roymilsh/VLSI_4bit_ALU/ALU Simulations/ADD-SUB.PNG

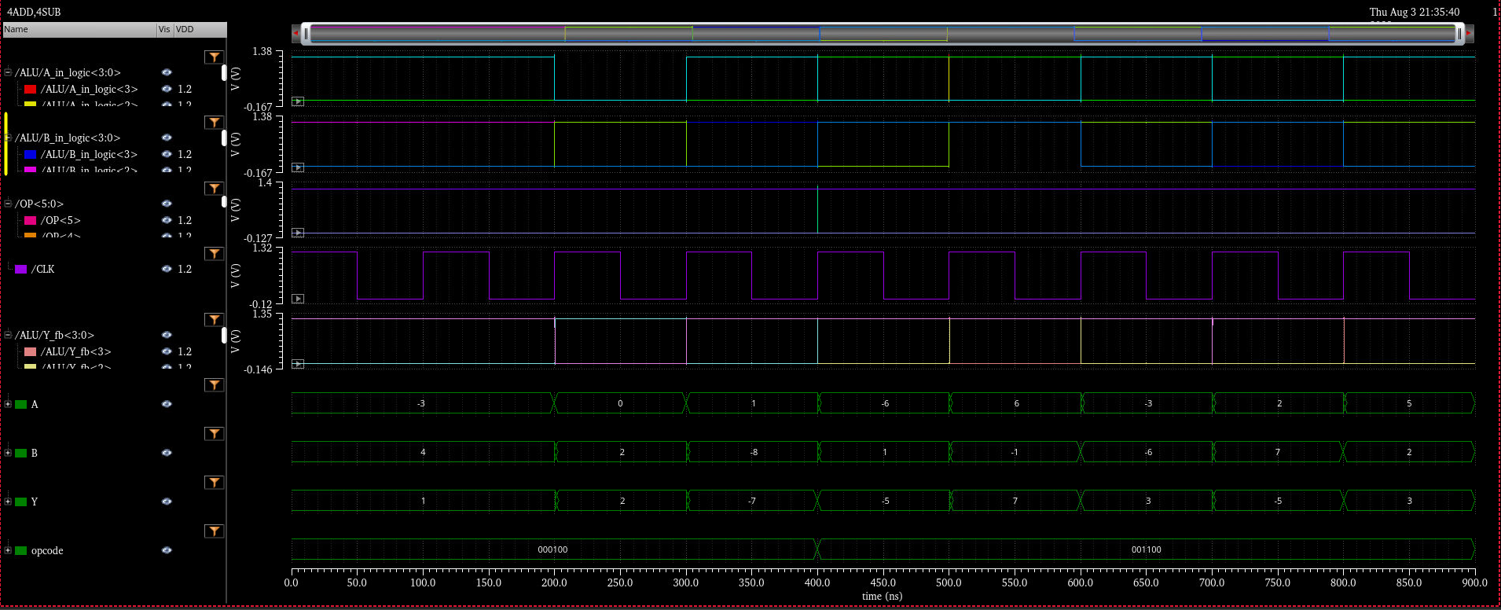
ALU Simulations/ADD-SUB.PNG
