roymilsh/VLSI_4bit_ALU/ALU Simulations/BSR.PNG

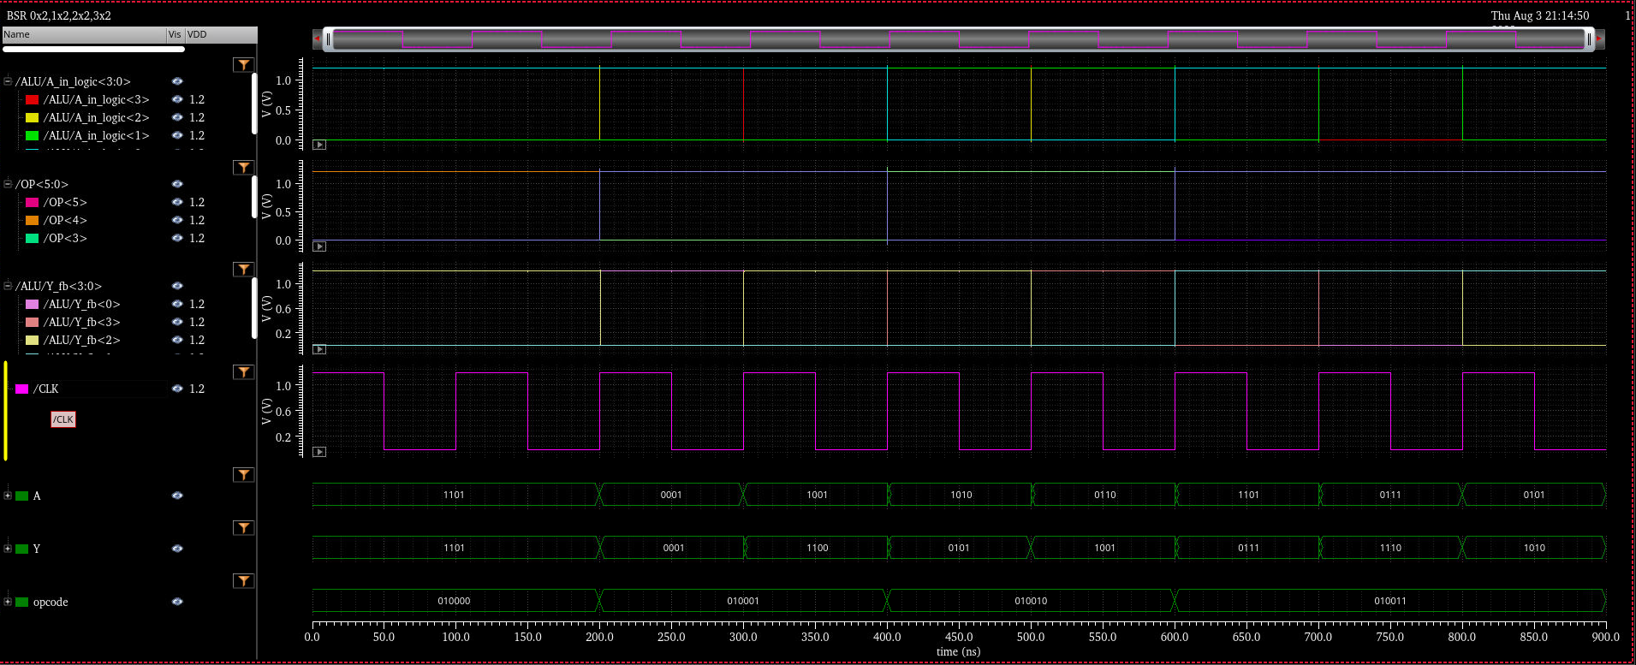
ALU Simulations/BSR.PNG
