roymilsh/VLSI_4bit_ALU/ALU Simulations/Feedback(add).PNG

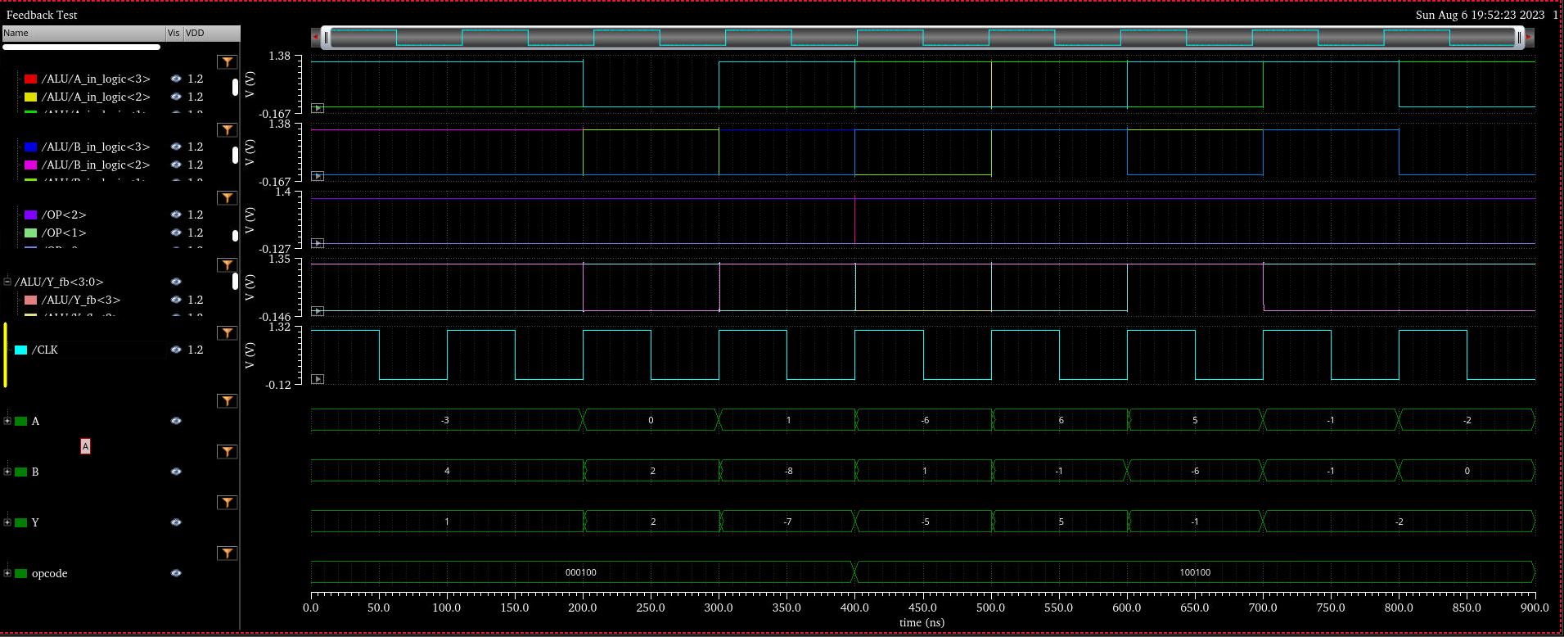
ALU Simulations/Feedback(add).PNG
