roymilsh/VLSI_4bit_ALU/ALU Simulations/NEG.PNG

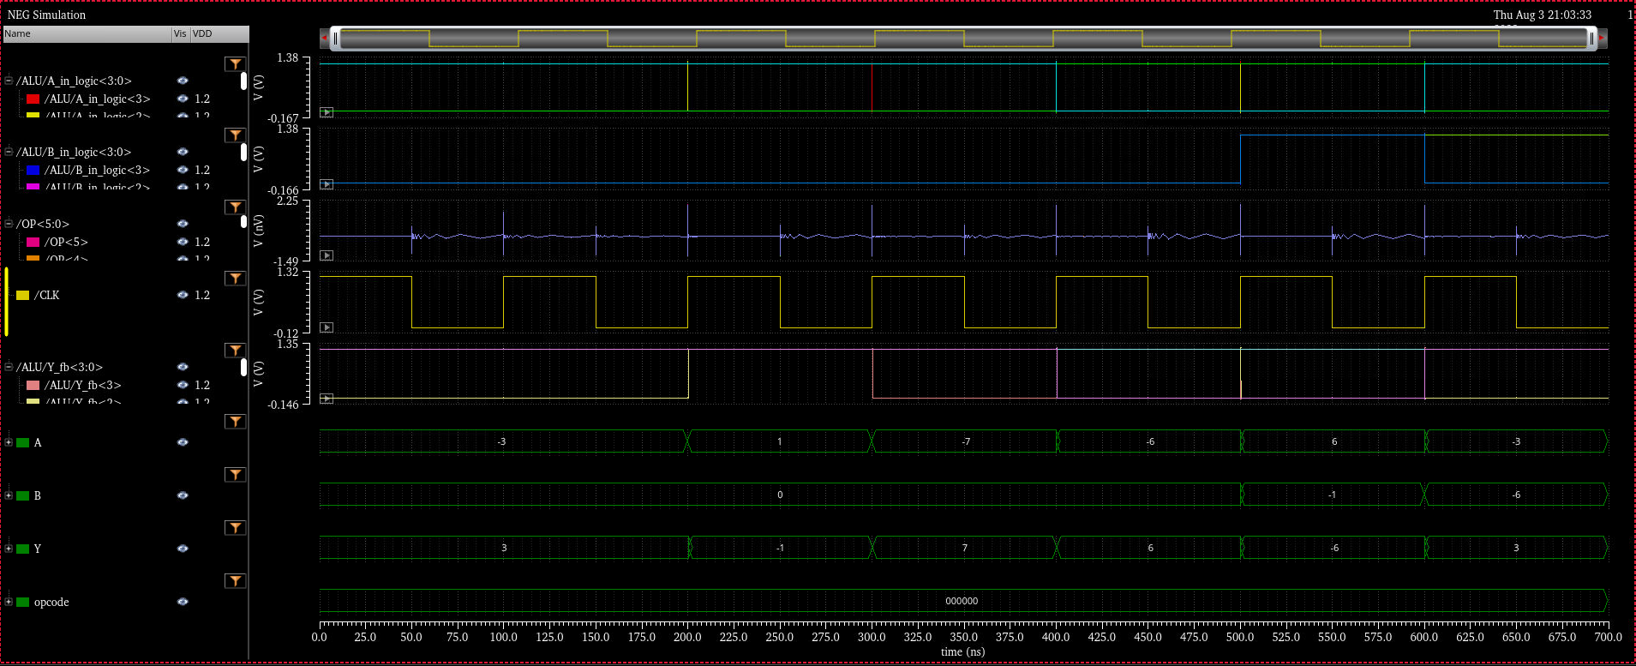
ALU Simulations/NEG.PNG
