roymilsh/VLSI_4bit_ALU/ALU Simulations/XOR-AND-OR.PNG

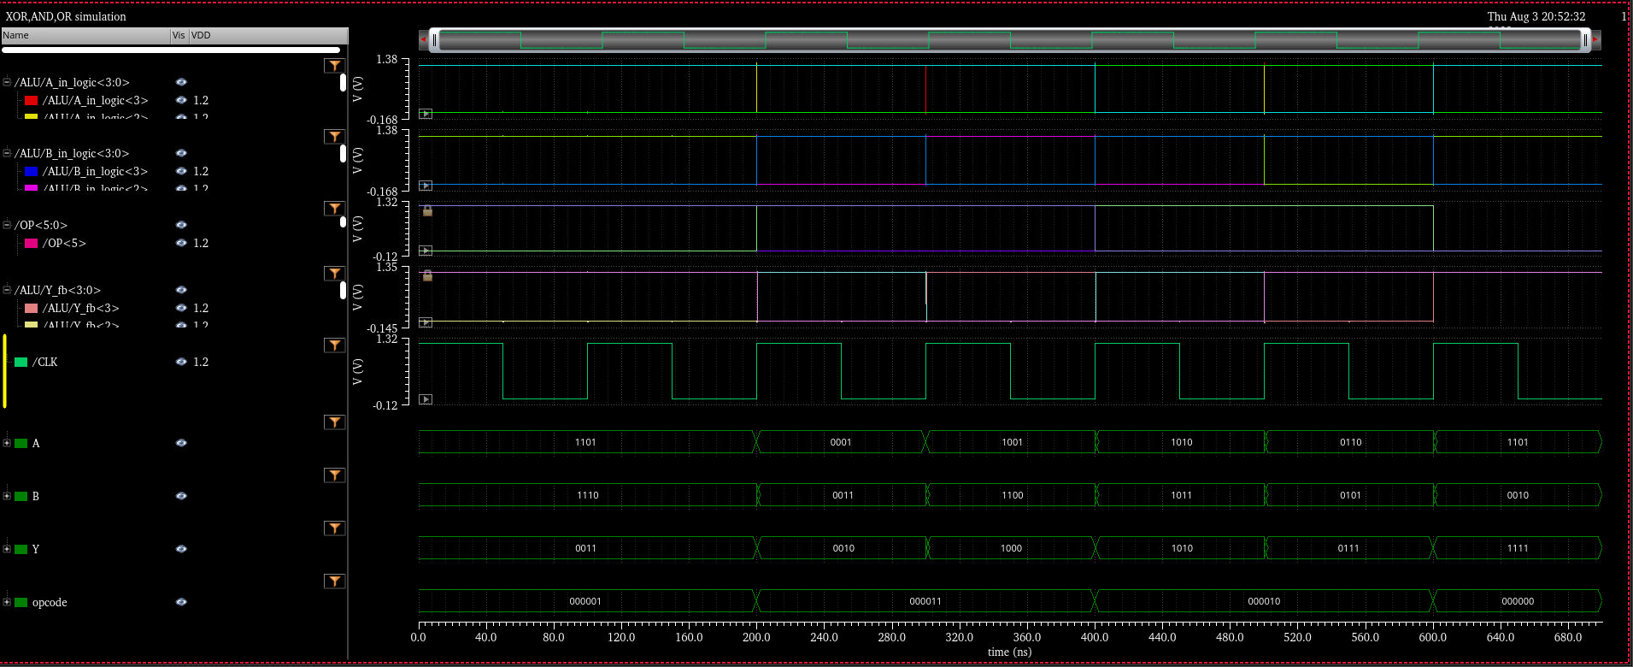
ALU Simulations/XOR-AND-OR.PNG
