roymilsh/VLSI_4bit_ALU/ALU_block_layout_virtuoso.PNG

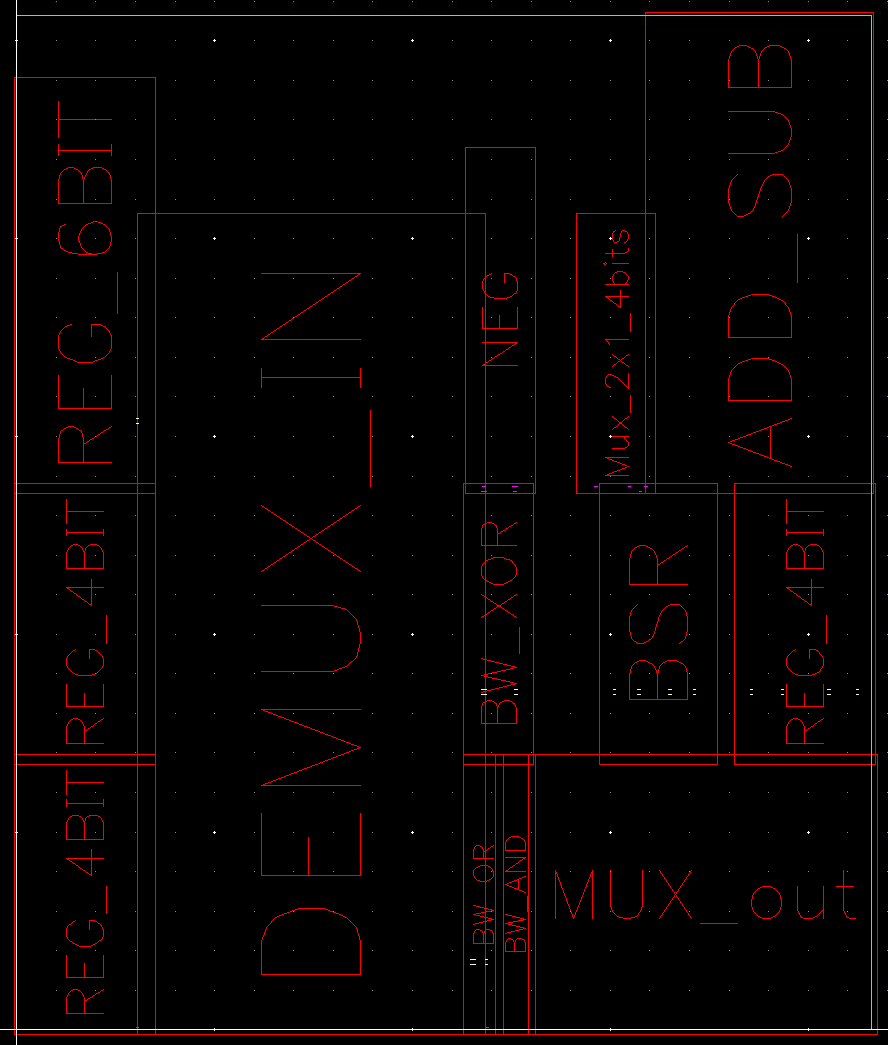
ALU_block_layout_virtuoso.PNG
