roymilsh/VLSI_4bit_ALU/ALU_full_layout_virtuoso.PNG

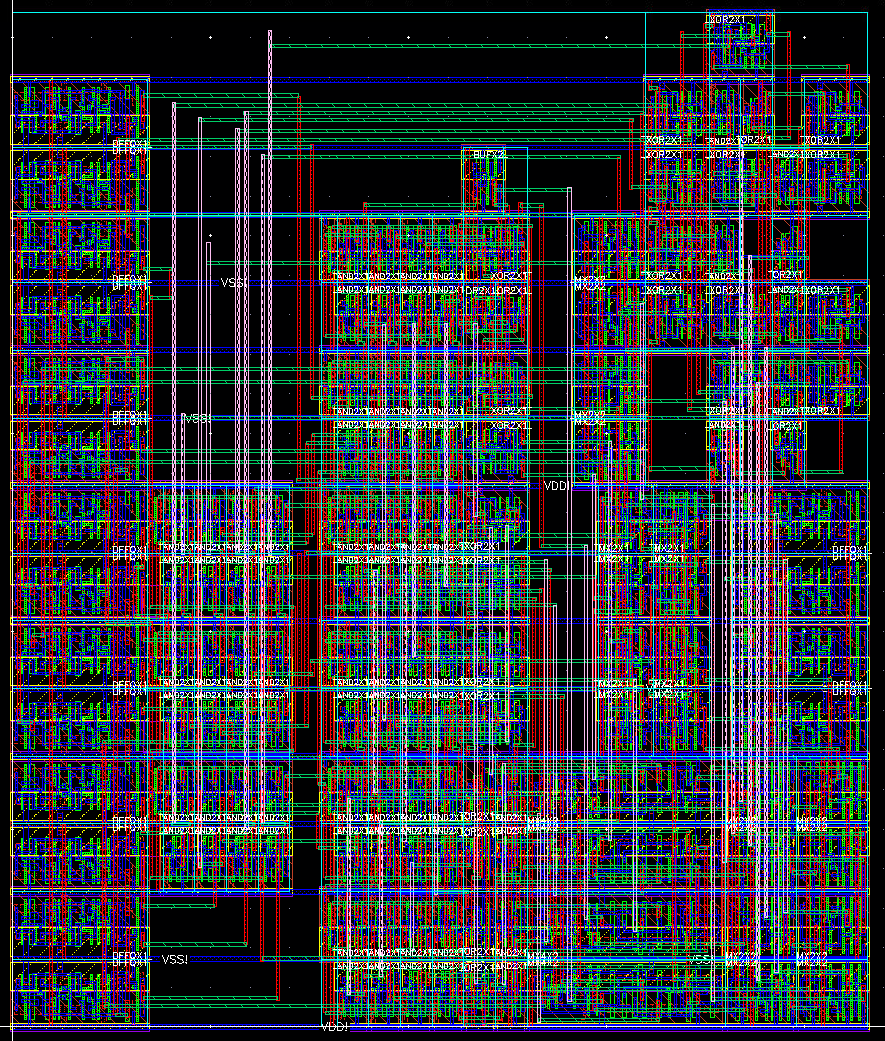
ALU_full_layout_virtuoso.PNG
