roymilsh/VLSI_4bit_ALU/layout sketch.PNG

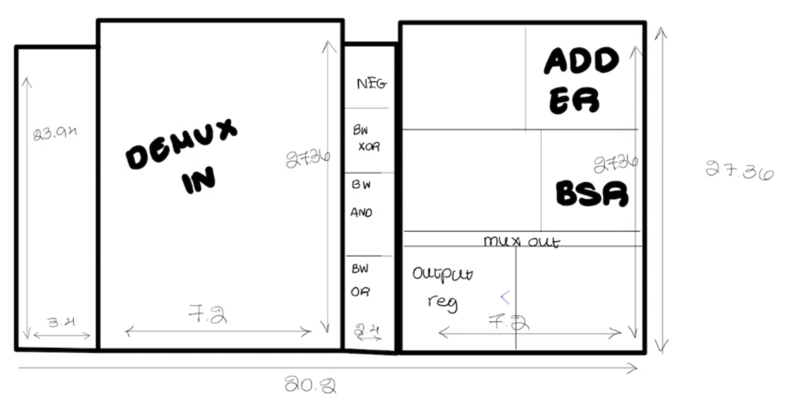
layout sketch.PNG
