roymilsh/VLSI_4bit_ALU/Logisim Implementation/BW_AND.PNG

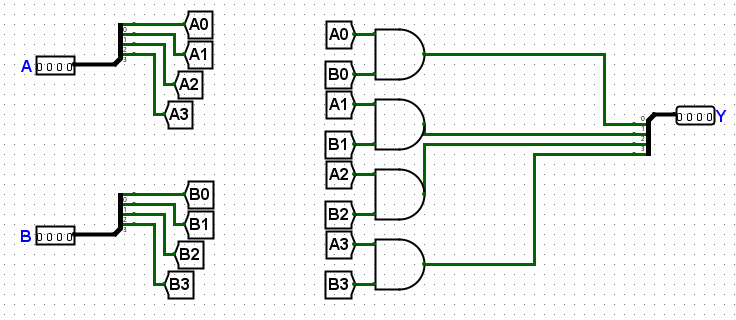
Logisim Implementation/BW_AND.PNG
