roymilsh/VLSI_4bit_ALU/Logisim Implementation/BW_NOT.PNG

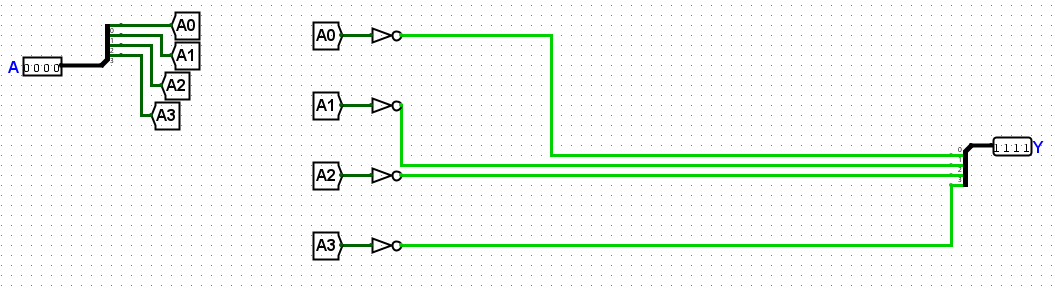
Logisim Implementation/BW_NOT.PNG
