roymilsh/VLSI_4bit_ALU/Logisim Implementation/BW_OR.PNG

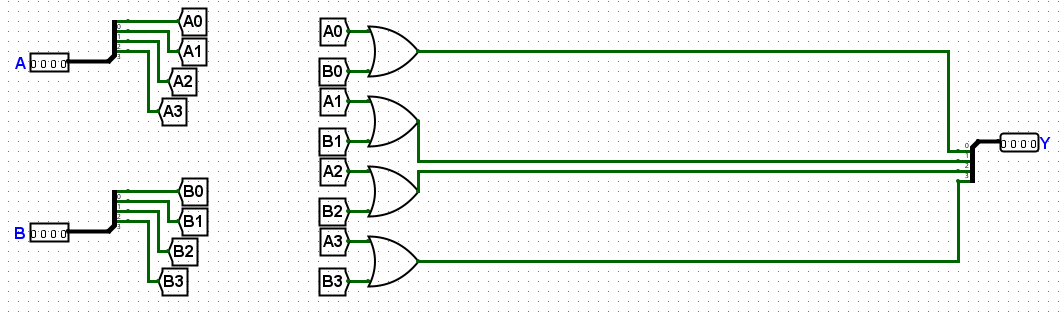
Logisim Implementation/BW_OR.PNG
