roymilsh/VLSI_4bit_ALU/Logisim Implementation/BW_XOR.PNG

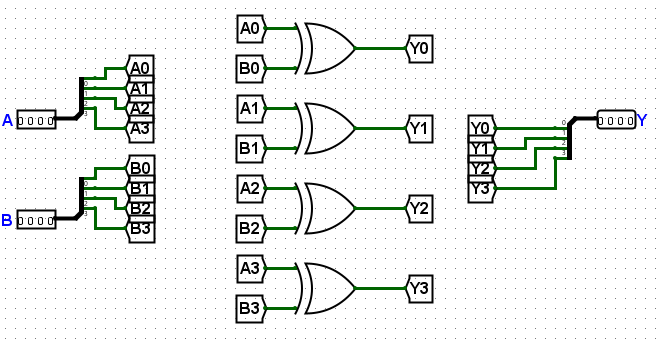
Logisim Implementation/BW_XOR.PNG
