roymilsh/VLSI_4bit_ALU/Logisim Implementation/DEMUX2.PNG

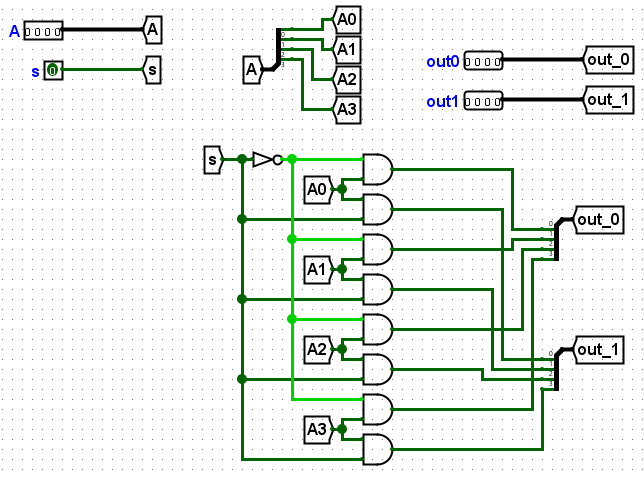
Logisim Implementation/DEMUX2.PNG
