roymilsh/VLSI_4bit_ALU/Logisim Implementation/DEMUX4.PNG

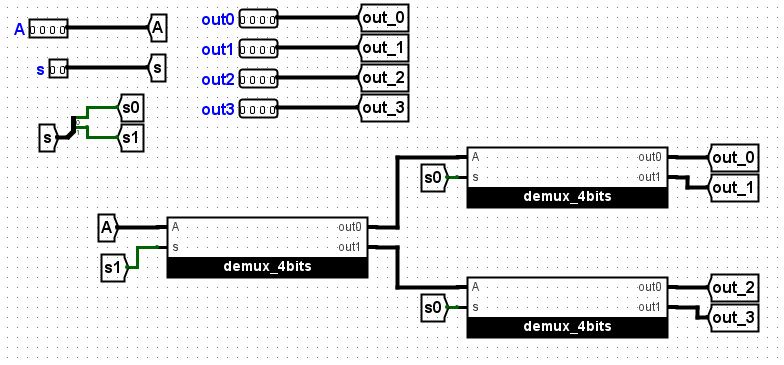
Logisim Implementation/DEMUX4.PNG
