roymilsh/VLSI_4bit_ALU/Logisim Implementation/DEMUX_IN.PNG

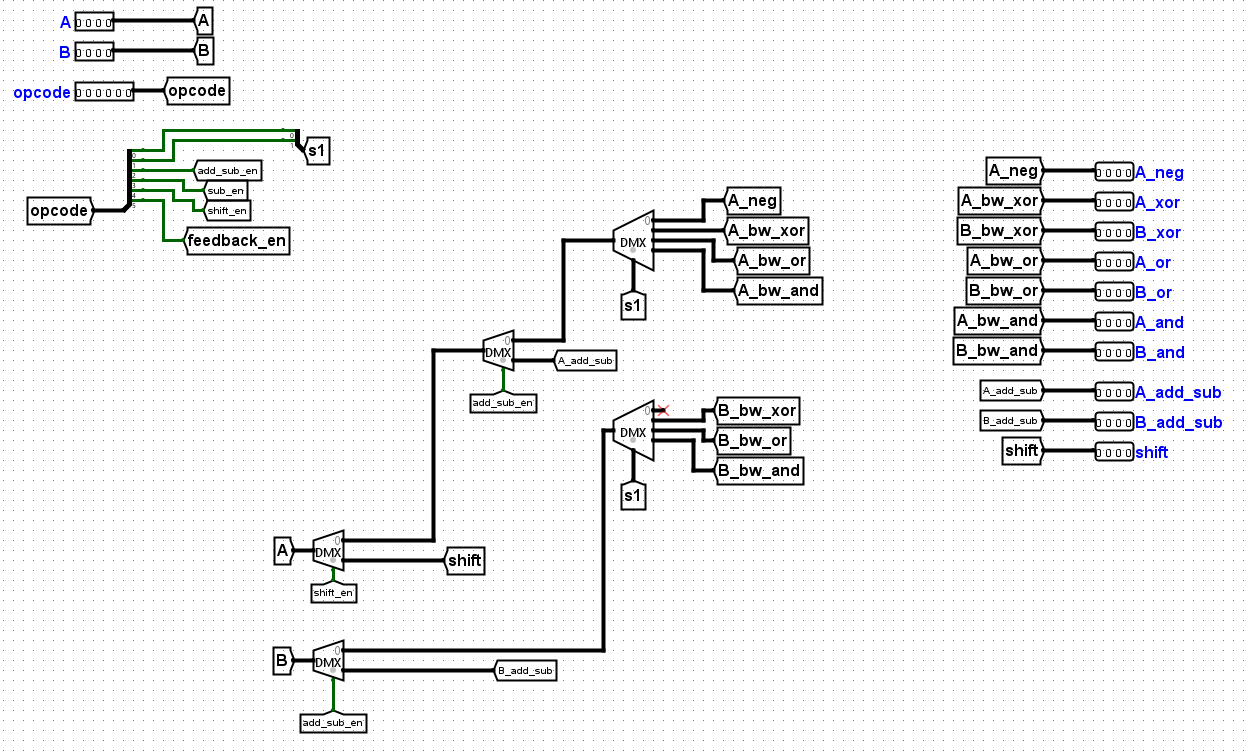
Logisim Implementation/DEMUX_IN.PNG
