roymilsh/VLSI_4bit_ALU/ALU Simulations/ADD-SUB.pdf

4ADD,4SUB | Thu Aug 3 21:35:40 2023

-0.167

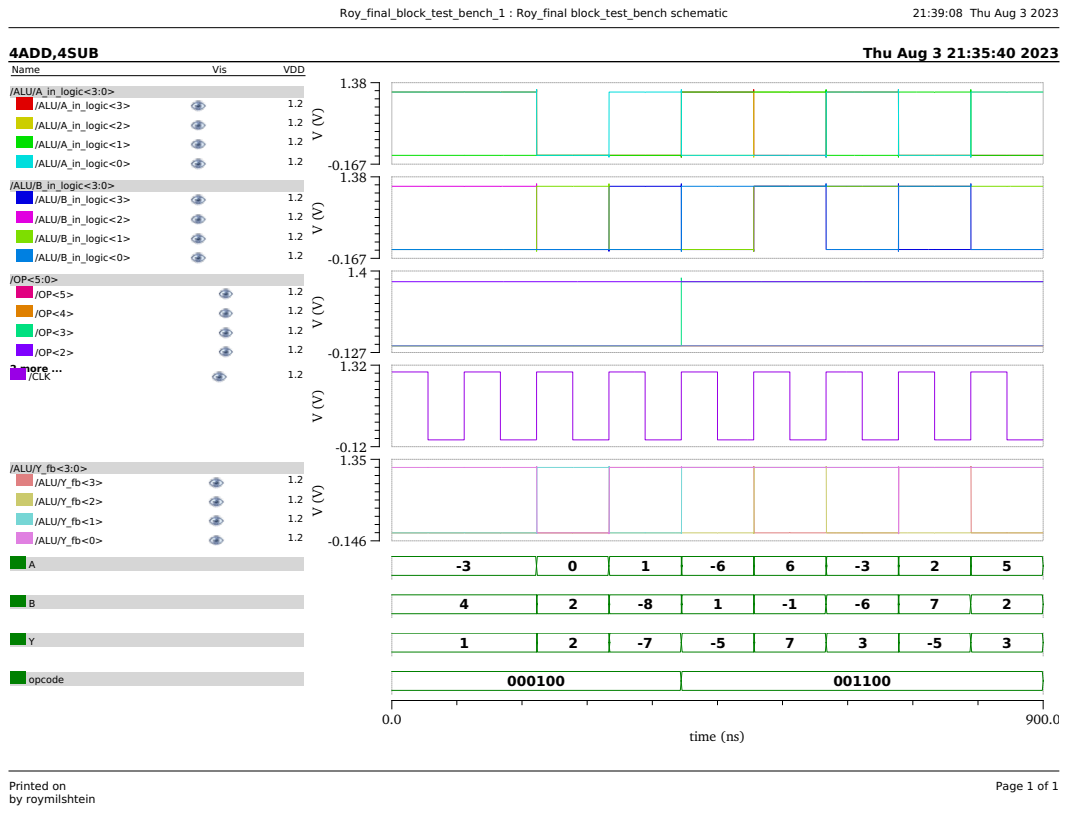
[picture p27: page 1]
Roy_final_block_test_bench_1 : Roy_final block_test_bench schematic; 21:39:08 Thu Aug 3 2023; Name; Vis; VDD; /ALU/A_in_logic<3:0>; /ALU/A_in_logic<3>; /ALU/A_in_logic<2>; /ALU/A_in_logic<1>; /ALU/A_in_logic<0>; 2 more ...; opcode; /ALU/Y_fb<3:0>; /ALU/Y_fb<3>; /ALU/Y_fb<2>; /ALU/Y_fb<1>; /ALU/Y_fb<0>; /CLK; /ALU/B_in_logic<3:0>; /ALU/B_in_logic<3>; /ALU/B_in_logic<2>; /ALU/B_in_logic<1>; /ALU/B_in_logic<0>; time (ns); Printed on by roymilshtein
