roymilsh/VLSI_4bit_ALU/ALU Simulations/BSR.pdf

BSR 0x2,1x2,2x2,3x2 | Thu Aug 3 21:14:50 2023

-0.168

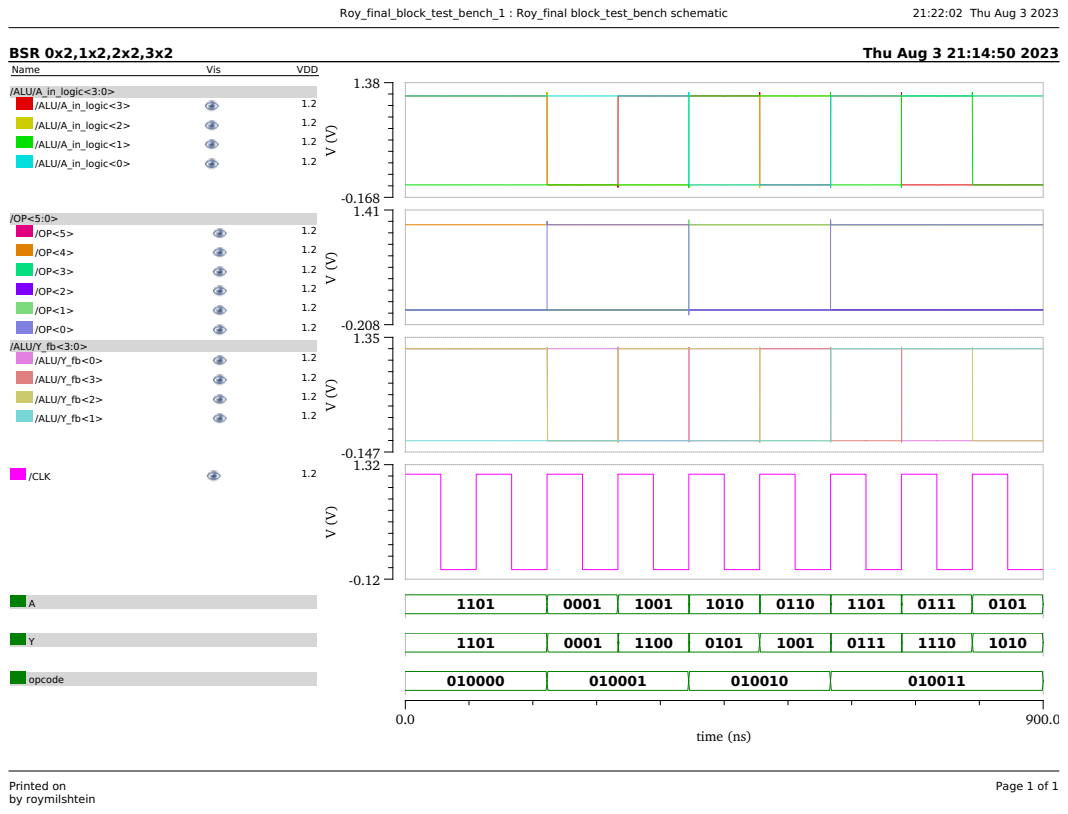
[picture p28: page 1]
Roy_final_block_test_bench_1 : Roy_final block_test_bench schematic; 21:22:02 Thu Aug 3 2023; Name; Vis; VDD; /ALU/A_in_logic<3:0>; /ALU/A_in_logic<3>; /ALU/A_in_logic<2>; /ALU/A_in_logic<1>; /ALU/A_in_logic<0>; opcode; /ALU/Y_fb<3:0>; /ALU/Y_fb<0>; /ALU/Y_fb<3>; /ALU/Y_fb<2>; /ALU/Y_fb<1>; /CLK; time (ns); Printed on by roymilshtein
