roymilsh/VLSI_4bit_ALU/ALU Simulations/XOR-AND-OR.pdf

XOR,AND,OR simulation | Thu Aug 3 20:52:32 2023

1.38

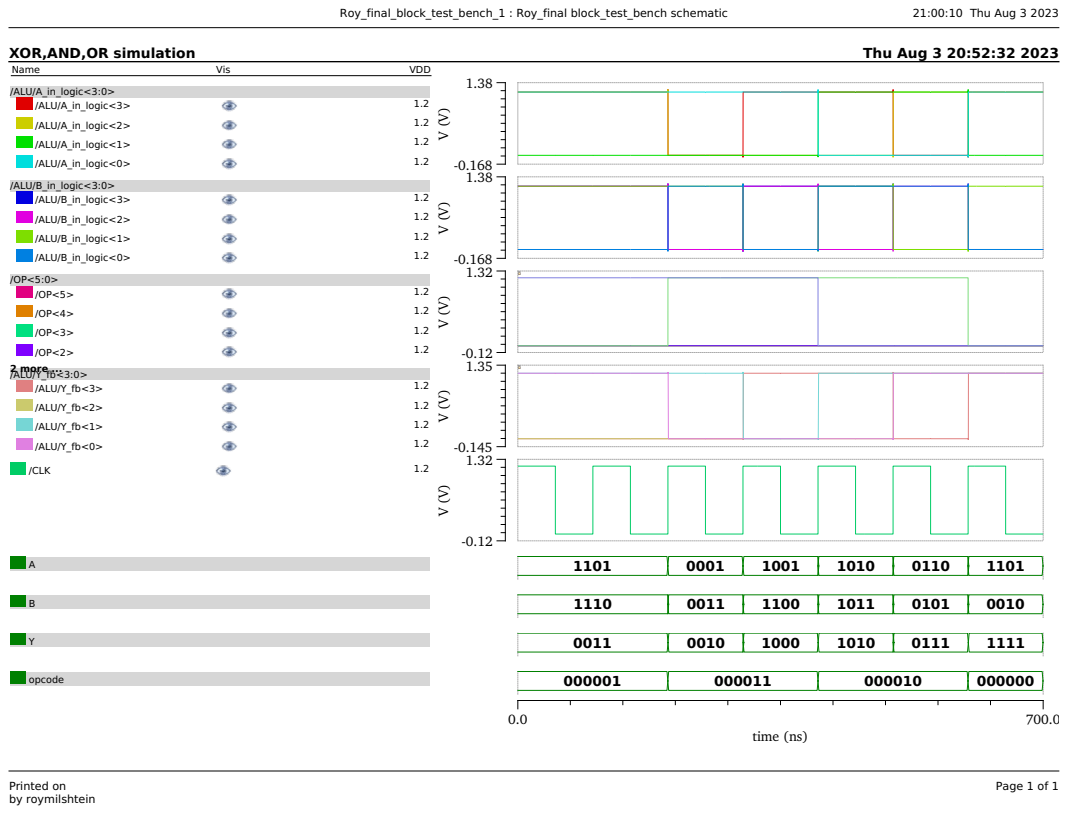
[picture p29: page 1]
Roy_final_block_test_bench_1 : Roy_final block_test_bench schematic; 21:00:10 Thu Aug 3 2023; Name; Vis; VDD; /ALU/B_in_logic<3:0>; /ALU/B_in_logic<3>; /ALU/B_in_logic<2>; /ALU/B_in_logic<1>; /ALU/B_in_logic<0>; opcode; /ALU/A_in_logic<3:0>; /ALU/A_in_logic<3>; /ALU/A_in_logic<2>; /ALU/A_in_logic<1>; /ALU/A_in_logic<0>; /ALU/Y_fb<3:0>; /ALU/Y_fb<3>; /ALU/Y_fb<2>; /ALU/Y_fb<1>; /ALU/Y_fb<0>; 2 more ...; /CLK; time (ns); Printed on by roymilshtein
