roymilsh/VLSI_4bit_ALU/(list of files, drawings)

Other design files:
ALU.circ
